lihua673/Smartlight-System/Core/Src/main.c

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
/* Includes ------------------------------------------------------------------*/
#include "main.h"

/* USER CODE BEGIN Includes */
#include "stm32f4xx_it.h"
#include "OLED.h"
#include "led_pwm.h"
#include "ld2402_uart.h"
#include "delay.h"
#include "app_state.h"
#include "BH1750.h"
#include "sensors.h"
#include "light_controller.h"
#include "cloud_comm.h"
#include "k210_uart.h"
#include "web_server.h"
#include <string.h>
#include <stdio.h>
/* USER CODE END Includes */

TIM_HandleTypeDef htim3;

UART_HandleTypeDef huart1;
UART_HandleTypeDef huart2;
UART_HandleTypeDef huart3;
UART_HandleTypeDef huart4;

void SystemClock_Config(void);
static void MX_GPIO_Init(void);
static void MX_USART1_UART_Init(void);
static void MX_USART3_UART_Init(void);
static void MX_TIM3_Init(void);
static void MX_USART2_UART_Init(void);
static void MX_UART4_UART_Init(void);
/**
  * @brief  The application entry point.
  * @retval int
  */
int main(void)
{

  /* MCU Configuration--------------------------------------------------------*/

  /* Reset of all peripherals, Initializes the Flash interface and the Systick. */
  HAL_Init();

  /* USER CODE BEGIN Init */
  Delay_Init();
  /* USER CODE END Init */

  /* Configure the system clock */
  SystemClock_Config();

  /* Initialize all configured peripherals */
  MX_GPIO_Init();
  MX_USART1_UART_Init();
  MX_USART3_UART_Init();
  MX_TIM3_Init();
  MX_USART2_UART_Init();
  MX_UART4_UART_Init();
  /* USER CODE BEGIN 2 */

		/* 硬件初始化 */
		LD2402_UART_Init();                             // 雷达UART接收
		K210_UART_Init();                               // K210人脸检测UART接收

		/* 启动诊断：PC0闪3次 + 串口输出（确认MCU在运行） */
		{
			uint8_t blink;
			const char *msg;
			msg = "\r\n=== LED系统启动 ===\r\n";
			HAL_UART_Transmit(&huart1, (uint8_t *)msg, strlen(msg), HAL_MAX_DELAY);
			for (blink = 0; blink < 3; blink++) {
				HAL_GPIO_TogglePin(GPIOC, GPIO_PIN_0);
				HAL_Delay(200);
			}
			HAL_GPIO_WritePin(GPIOC, GPIO_PIN_0, GPIO_PIN_SET);
		}

		OLED_Init();                                    // OLED初始化
		LED_PWM_Init();                                 // PWM输出

		/* PWM启动测试：LED闪3次（30%→60%→100%），确认硬件正常 */
		{
			const char *pwm_msg = "PWM: LED test 30%%->60%%->100%%\r\n";
			HAL_UART_Transmit(&huart1, (uint8_t *)pwm_msg, strlen(pwm_msg), HAL_MAX_DELAY);
			LED_SetBrightness(300);  HAL_Delay(300);
			LED_SetBrightness(0);    HAL_Delay(200);
			LED_SetBrightness(600);  HAL_Delay(300);
			LED_SetBrightness(0);    HAL_Delay(200);
			LED_SetBrightness(999);  HAL_Delay(300);
			LED_SetBrightness(0);    // 关掉，等主循环接管
		}

		BH1750_Init();                                  // 光照传感器

		/* 云端连接（耗时长，IWDG必须在之后启动否则超时复位） */
		Cloud_Init();

		/* Web控制面板（WiFi连接后启动TCP Server）*/
		WebServer_Init();

		/* 独立看门狗初始化（~4s超时，主循环喂狗） */
		RCC->CSR |= RCC_CSR_LSION;          // 启用LSI
		while (!(RCC->CSR & RCC_CSR_LSIRDY)); // 等待LSI就绪
		IWDG->KR = 0x5555;    // 解除写保护
		IWDG->PR = 0x04;      // 64分频, LSI=32kHz -> 500Hz
		IWDG->RLR = 2000;     // 2000 ticks -> 4s超时（留余量给重连）
		IWDG->KR = 0xCCCC;    // 启动IWDG

		/* 主循环 */
		while (1)
		{
	    IWDG->KR = 0xAAAA;  // 喂狗

	    // 1. I/O轮询（必须尽可能频繁调用）
	    LD2402_ParseData();
	    K210_ParseFrame();
		    WebServer_Poll();

	    // 2. 传感器采集 + 亮度控制
	    SensorData_t sensor;
	    Sensors_ReadAll(&sensor);
	    uint16_t target = LightCtrl_Update(&sensor);
	    if (target != g_led_duty)
	    {
	        char duty_dbg[48];
	        snprintf(duty_dbg, sizeof(duty_dbg), "LED: %d -> %d (lux=%.1f)\r\n",
	            g_led_duty * 100 / 999, target * 100 / 999, (double)sensor.lux);
	        HAL_UART_Transmit(&huart1, (uint8_t *)duty_dbg, strlen(duty_dbg), HAL_MAX_DELAY);
	        g_led_duty = target;
	        LED_SetBrightness(target);
	    }

	    // 3. 云端上传（内部20s节流）
	    Cloud_Upload(g_led_duty * 100 / 990);

	    // 4. 断线重连（内部30s间隔限制）
	    Cloud_TryReconnect();

	    // 5. OLED实时状态刷新（1s间隔）
	    static uint32_t last_oled_tick = 0;
	    static uint32_t uptime = 0;
	    if (HAL_GetTick() - last_oled_tick >= 1000)
	    {
	        last_oled_tick = HAL_GetTick();
	        uptime++;

	        /* 第1行：运行时间 + 光照值 */
	        OLED_ShowString(1, 1, "T:");
	        OLED_ShowNum(1, 3, uptime, 5);
	        OLED_ShowString(1, 9, "L:");
	        OLED_ShowNum(1, 11, (uint32_t)sensor.lux, 5);

	        /* 第2行：LED亮度 */
	        OLED_ShowString(2, 1, "LED:");
	        OLED_ShowNum(2, 5, g_led_duty * 100 / 999, 3);
	        OLED_ShowString(2, 8, "% F:");
	        OLED_ShowNum(2, 12, sensor.face_count, 1);

		        /* 第3行：人体检测 */
		        OLED_ShowString(3, 1, "Human:");
		        OLED_ShowString(3, 8, sensor.human_present ? "YES" : "NO ");

		        /* 第4行：IP地址(WebServer) / 云端状态 */
		        {
		            const char *ip = WebServer_GetIP();
		            if (ip) {
		                OLED_ShowString(4, 1, (char *)ip);
		            } else {
		                OLED_ShowString(4, 1, "Cloud:");
		                OLED_ShowString(4, 8, Cloud_IsConnected() ? "OK " : "ERR");
		            }
		        }

	        /* 串口同步打印关键值，方便调试 */
	        {
	            char dbg[64];
	            snprintf(dbg, sizeof(dbg), "T:%lu Lux:%.1f LED:%d%% Human:%d Face:%d Cloud:%d\r\n",
	                uptime, (double)sensor.lux,
	                (int)(g_led_duty * 100 / 999),
	                sensor.human_present,
	            sensor.face_count,
	                Cloud_IsConnected());
	            HAL_UART_Transmit(&huart1, (uint8_t *)dbg, strlen(dbg), HAL_MAX_DELAY);
	        }
	    }
		}

  /* USER CODE END 2 */

  /* Infinite loop */
}

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
