lihua673/Smartlight-System/Core/Inc/main.h

#define LD2402_5_RX_Pin GPIO_PIN_10
#define LD2402_5_RX_GPIO_Port GPIOB
#define LD2402_4_TX_Pin GPIO_PIN_11
#define LD2402_4_TX_GPIO_Port GPIOB
#define ESP_RST_Pin GPIO_PIN_15
#define ESP_RST_GPIO_Port GPIOD
#define ESP_CH_PD_Pin GPIO_PIN_6
#define ESP_CH_PD_GPIO_Port GPIOC
#define K210_TX_Pin GPIO_PIN_10
#define K210_TX_GPIO_Port GPIOC
#define K210_RX_Pin GPIO_PIN_11
#define K210_RX_GPIO_Port GPIOC
