lihua673/Smartlight-System/Core/Src/delay.c

#include "delay.h"

/* 初始化DWT周期计数器用于精确微秒延时 */
void Delay_Init(void)
{
    CoreDebug->DEMCR |= CoreDebug_DEMCR_TRCENA_Msk;
    DWT->CYCCNT = 0;
    DWT->CTRL |= DWT_CTRL_CYCCNTENA_Msk;
}

/* 精确微秒延时 (基于DWT->CYCCNT, 168MHz下精度约6ns) */
void Delay_us(uint32_t us)
{
    uint32_t start = DWT->CYCCNT;
    uint32_t ticks = us * (SystemCoreClock / 1000000UL);
    while ((DWT->CYCCNT - start) < ticks);
}
