lihua673/Smartlight-System/(commit log)

2026-07-07 Initial commit: 原始项目
2026-07-07 Phase 1: 代码质量优化 - WiFi密码外移、清理死代码、OLED延时/Pow查表优化
2026-07-07 Phase 2: 性能优化 - 统一软件I2C驱动、DWT精确延时、GPIO方向快速切换
2026-07-07 Phase 3: 健壮性优化 - BH1750 Wait_Ack重试保护、全局变量统一管理AppState、UART_SendStr安全化
2026-07-07 Phase 4: 架构重构 - 三层模块解耦(Sensors/LightCtrl/Cloud)、IWDG看门狗、WiFi/MQTT自动重连、OLED实时状态显示
2026-07-07 Fix: 修复app_state.c宏自引用和esp8266.c中文引号编译错误
2026-07-07 Fix: I2C ACK时钟缺失、上拉电阻、时序硬编码、BH1750 lux转换等6个Bug
    [BH1750.c, BH1750.h, OLED.c, esp8266.c, main.c, sensors.c, soft_i2c.c]
2026-07-07 Fix: IWDG移到Cloud_Init之后，防止ESP8266初始化时看门狗超时无限复位
2026-07-07 Fix: MQTT_Init返回状态值，Cloud_Init/TryReconnect检查返回值，防止MQTT失败时误设mqtt_ready
2026-07-07 Fix: 更新OneNET设备鉴权token
2026-07-07 Fix: OneNET MQTT Client ID/Username改为新版格式 {产品ID}&{设备名}
    [esp8266.c]
2026-07-07 Fix: OneNET MQTT服务器地址改为新平台 iot-open.one-net.com.cn
    [esp8266.c]
2026-07-07 Fix: 回退Client/Username为原始格式，MQTT服务器改用直连IP 183.230.40.96
2026-07-07 Fix: 用正确的设备密钥重新生成OneNET鉴权token
2026-07-07 Fix: 修正OneNET token签名算法(HMAC输入应为et\nmethod\nres\nversion而非仅et)
2026-07-07 Feat: OLED加运行时间计数器+串口同步打印，方便验证系统是否在运行
2026-07-14 Chore: 完善.gitignore，排除Keil编译产物；移除已追踪的build artifacts
2026-10-08 Chore: 排除个人学习笔记，同步Keil工程配置
2026-10-08 Docs: 添加项目README（架构说明、硬件清单、软件设计与编译步骤）
